bardonfro/generator-controller-radio/Generator Contoller Schematic.pdf

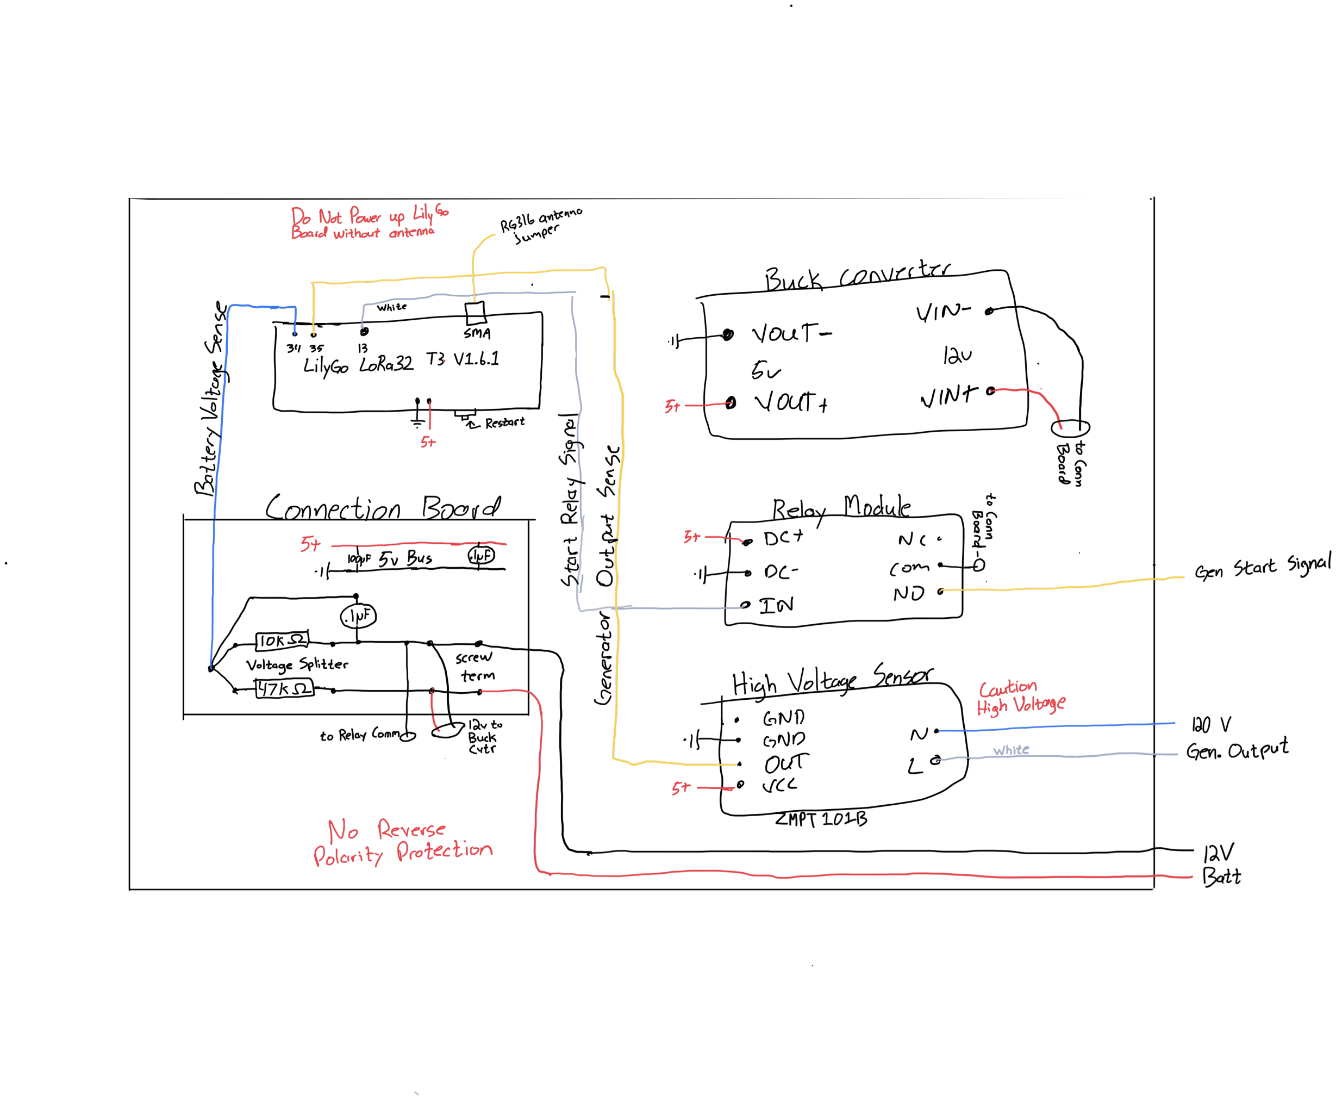
[picture p1: page 1]
