bardonfro/generator-controller-radio/(commit log)

2026-05-29 Improved timer display after UI reload.
2026-05-29 Added safety timer feature.
2026-05-29 Added sketch to test voltage sensing circuits.
2026-05-29 Controller phase 5: voltage sensing and misc
2026-06-01 Housekeeping and bug fixes
    [controller.ino, server.ino]
2026-10-08 Added diagnostic info to the bottom of the web UI. Also minor changes due to board update.
2026-10-09 Server v1.1: timer enforcement, two-phase ACK timeout, lastMessageMs, boot status request, state restore from heartbeat, WiFi/OLED fixes
    [server.ino]
2026-10-09 Controller v1.1: timer validation, CMD:STATUS, boot heartbeat, uncommanded shutdown monitor, TMR heartbeat field, 2s sense update, LOCAL_TEST_MODE
2026-10-09 Docs: protocol v1.1, two-phase timeout, state restore, local test mode, staged-flash test plan
2026-10-09 Controller: fix misplaced brace around LOCAL_TEST_MODE block, undef board OLED pin macros
    [controller.ino]
2026-10-09 v1.1.1: boot reset-reason diagnostic, version bump, docs and test checklist updated with hardware-verified items
    [controller.ino, server.ino]
